grilletjesus/TESIS/ERROR1.png

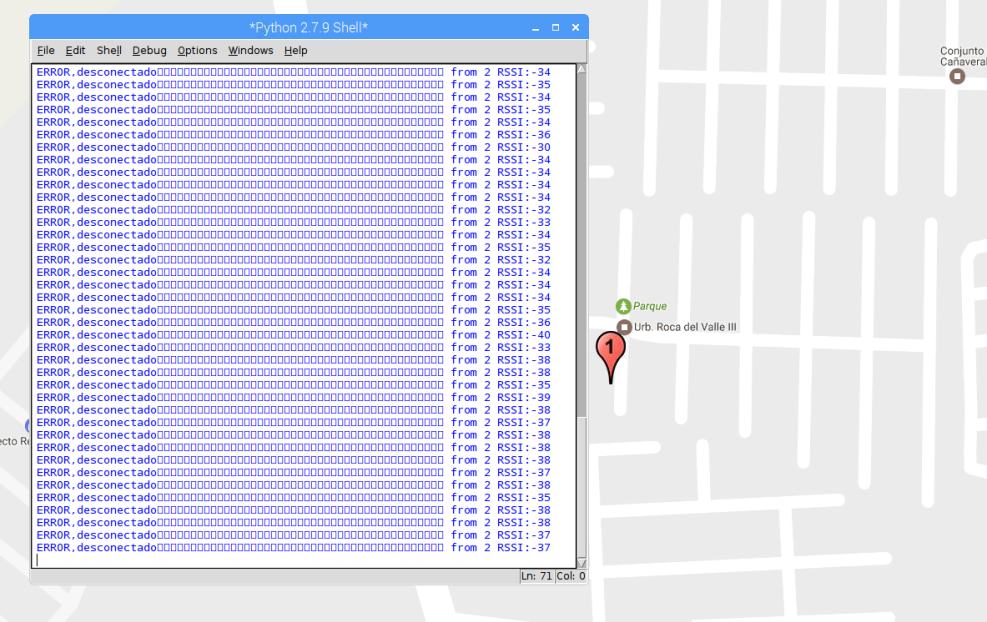
ERROR1.png
