grilletjesus/TESIS/ERRORconmapa.png

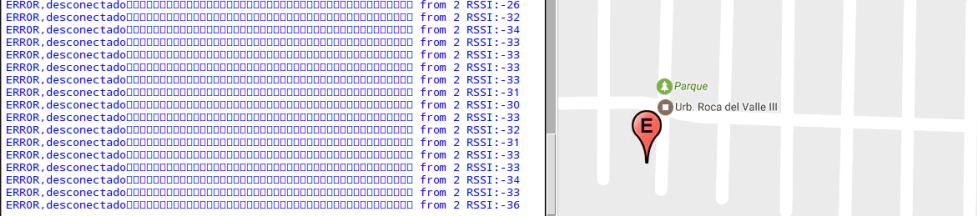
ERRORconmapa.png
