grilletjesus/TESIS/TrabajoFinalv1.docx

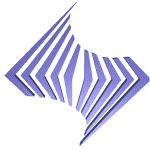
[picture p3: figure]
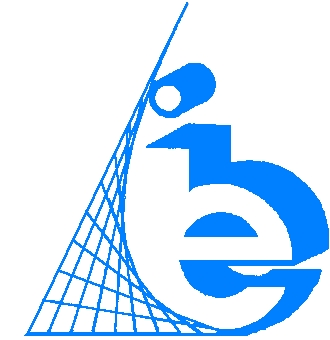
[picture p4: figure]

| U N E X P O | UNIVERSIDAD NACIONAL EXPERIMENTAL POLITÉCNICA “ANTONIO JOSÉ DE SUCRE” VICERRECTORADO BARQUISIMETO DEPARTAMENTO DE INGENIERÍA ELECTRÓNICA

SISTEMA INALÁMBRICO DE RASTREO Y MONITORIZACIÓN PARA REBAÑOS DE GANADO.

Autor: Br. Jesús Manuel Grillet González

Expediente: 20092-0338

Tutor: Dr. Jorge Agüero

Marzo, 2016

RESUMEN

INTRODUCCIÓN

CAPÍTULO I

PLANTEAMIENTO DEL PROBLEMA

DESCRIPCIÓN DEL PROBLEMA

En la actualidad el crecimiento poblacional y sus imprescindibles necesidades de alimentación han llevado al aumento del número de pequeños productores y de la producción de las empresas agropecuarias, las cuales cada cierto tiempo requieren incrementar el tamaño y/o cantidades de ganado y áreas de siembra, para satisfacer las necesidades de la población. En consecuencia, se precisa mucho más personal para mano de obra, vigilancia, regulación y gerencia de los diversos recursos y materias que se producen.

La situación coyuntural económica y social que se desarrolla en el país, presenta diversas problemáticas para las empresas de producción. Entre estos problemas se encuentran el auge en el crimen, robos, secuestros y asesinatos. Ligado con esta problemática, la falta de alimentos y los altos costos de los productos, generan un ambiente de constante peligro.

El abigeato, actualmente, es un problema común en granjas de crianza de ganado, la amplia extensión de terrenos y la falta de constante vigilancia, ha permitido la proliferación de este acontecimiento, la mayoría de las veces sin testigos ni culpables a los cuales presentar cargos. Esta situación, de sostenerse de forma prolongada a través del tiempo, degradaría aún más la situación de las empresas productoras, generando pérdidas sumadas a la situación de desestabilidad económica, pudiendo dejarlas en bancarrota.

Para controlar y dar solución a esta situación constante de abigeato de ganado, se propone el desarrollo de un sistema de rastreo y seguridad para el ganado que permita mantener una vigilancia constante.

Un sistema de rastreo consiste de varias etapas: captura de la posición mediante un GPS, procesamiento e interpretación de los datos obtenidos, visualización de la posición y, finalmente, una base de datos que registre la información. Un sistema de seguridad consiste en un detector y un dispositivo de notificación y acción al momento de ser detectada la situación no deseada que cumple parámetros previamente establecidos.

Se plantea el desarrollo de un sistema inalámbrico de rastreo y monitorización para rebaños de ganado compuesto por collares que serán los sistemas de adquisición y transmisión de datos, a su vez se subdividen en nodos principales que son transmisores de larga distancia, nodos secundarios de corta distancia y una central de control estacionaria que se ubicaría en un punto de supervisión.

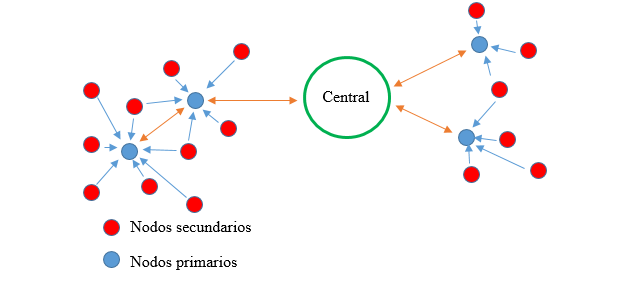
[picture p5: figure]

Figura 1.1 Diagrama del sistema

En la figura se observa un ejemplo de cómo los nodos secundarios en color rojo, enviarían su señal a los nodos principales los de color azul, quienes se encargan de transmitir la información a la central del sistema.

Los nodos primarios son collares que poseen una circuitería más compleja por lo que serán colocados a una cantidad pequeña de animales en el rebaño, mientras que al resto le será colocado el nodo secundario que es un collar más simple y de costo reducido.

La información de localización será obtenida en el nodo principal mediante un collar que estará compuesto por un microcontrolador, un sistema de posicionamiento global (GPS.), un transceptor inalámbrico, batería y un circuito de seguridad del collar, como se observa en el diagrama continuación.

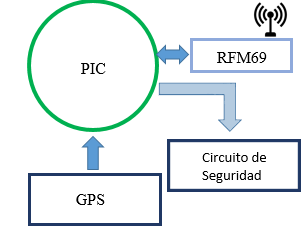
[picture p6: figure]

Figura 1.2 Nodo Principal

El circuito de seguridad consistirá en un par de cables en la parte interna de la correa del collar, por los cuales fluirá una corriente eléctrica, al ser removido el collar o ser cortada la correa se perdería esta señal generando una interrupción y activando una alarma.

El nodo secundario estará compuesto por un microcontrolador, un transceptor inalámbrico y un circuito de seguridad como se muestra en el siguiente diagrama.

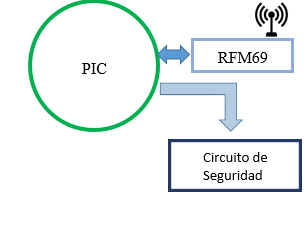
[picture p7: figure]

Figura 1.3 Nodo secundario

La información será transmitida a una central estacionaria, compuesta por una computadora Raspberry Pi, un transceptor inalámbrico, una interfaz visual y la circuitería de notificación.

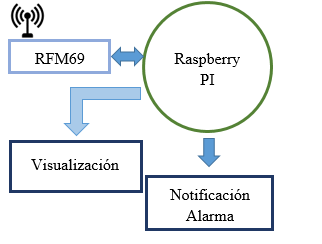
[picture p8: figure]

Figura 1.4 Central estacionaria

La Raspberry Pi es una computadora embebida la cual procesará los datos obtenidos de nodos principales en el ganado para ser registrados, mostrados y, en caso de ser necesario, realizar las notificaciones o alertas que se requieran.

JUSTIFICACIÓN

La ganadería representa para los venezolanos, y para las personas de todos los gentilicios, una fuente de producción de alimentos, de desarrollo económico y autosuficiencia del país. Esto implica un gran impacto tanto económico como social, la necesidad presentada por sectores de la población ha llevado al abigeato de cabezas de ganado, ya sea por necesidad de alimentación o por fines de lucro para los trasgresores de la ley.

La problemática de abigeato de cabezas de ganado, mencionada anteriormente, se prevé que se agudice por la degradación de la situación económica y social del país. El desarrollo de un sistema de rastreo y monitoreo inalámbrica facilitará la localización del rebaño, en llano y pradera, y alertará, de manera inmediata, si el rebaño se acerca al límite del territorio o si se detecta la remoción del collar.

La solución a esta problemática, si bien no mejoraría de manera significativa la situación económica y social del país, si sería un avance para el desarrollo tecnológico en materia de agropecuaria y seguridad, además ofrecería seguridad a la inversión que se realiza, reduciendo pérdidas y, por consiguiente, el valor final del producto, lo cual sería un gran beneficio para todos en el largo plazo.

OBJETIVOS

Objetivo General

Desarrollar un sistema inalámbrico de rastreo y monitorización para rebaños de ganado.

Objetivos Específicos

- Proponer los dispositivos, módulos e instrumentos a ser utilizados para la adquisición, procesamiento y transmisión de los datos en función de su desempeño.
- Desarrollar el software que permita, al microcontrolador, la interpretación de los formatos NMEA de geolocalización utilizado por el módulo GPS.
- Desarrollar el software en PIC y Raspberry PI que realice la comunicación entre ellos mediante el uso de un transceptor inalámbrico.
- Desarrollar el software de la estación central para monitoreo de los distintos collares, que ejecute: el registro, la visualización, la generación de alarmas en el rebaño que está siendo rastreado.
- Construir el hardware para el prototipo del collar que permita la adquisición y transmisión de los datos de geolocalización.
- Construir el hardware de recepción de datos y de notificación audiovisual para la central estacionaria.
- Evaluar el funcionamiento del prototipo por medio de pruebas que verifiquen su correcto funcionamiento.

ALCANCES Y LIMITACIONES

El sistema de rastreo y monitorización desarrollado tiene como meta principal vigilar la localización, seguridad de animales en campos abiertos, y la visualización de estas variables en un entorno grafico e intuitivo.

Se elabora solo un dispositivo de adquisición de datos y la central estacionaria de monitoreo, notificación y visualización de los datos. Para realizar las pruebas y validaciones del sistema.

El rango de transmisión de los datos está condicionado por las características geográficas en las cuales se encuentre desplegado el dispositivo.

CAPÍTULO II

MARCO TEÓRICO

ANTECEDENTES

En los últimos años ha surgido una amplia variedad de tecnología en el ámbito de monitoreo y localización de animales, tanto domésticos como salvajes, las cuales han sido empleadas en diversos países con distintas aplicaciones dando soluciones a problemas presentados.

Huircan (2009). Desarrolla junto a un equipo multidisciplinario en la universidad de la frontera Chile, un sistema es una plataforma TIC para el rastreo remoto de ganado en ambiente de pastoreo, esta plataforma apunta a monitorear variables biológicas y localización de bovinos en pradera, variables que permiten la determinación de enfermedades, celo y robo. Esta considera los siguientes elementos para realizar el monitoreo: dispositivos fijos instalados dentro del perímetro que define el predio, dispositivos móviles instalados en la oreja del animal, un dispositivo administrador por predio el cual se encarga de adquirir, registrar, calcular y transmitir alámbrica o inalámbricamente a través de un protocolo propietario variables de temperatura y localización espacial de cada animal en predio a intervalos fijos de tiempo y configurables.

De este trabajo se toman la idea principal de un sistema de localización de bovinos en pradera y su monitoreo para evitar su robo, la utilización de una computadora principal administradora que se encargue de recopilar, registrar y mostrar las variables de posición y seguridad de cada animal en intervalos fijos de tiempo configurables.

Casanova-Chirino (2014). En su trabajo describen el funcionamiento y rendimiento de la computadora Raspberry Pi B antecesor de la computadora usada como administrador central del sistema desarrollado en este trabajo. Proporciona las bases teóricas del funcionamiento tanto en software como en hardware, las limitaciones, alcances y funcionalidades que posee, esta computadora, para el desarrollo de aplicaciones tecnológicas.

Hoss (2015). En su trabajo de grado realizó un sistema de rastreo y monitoreo de unidades del sistema de transporte. Este sistema está compuesto por un sistema de adquisición de datos, una interfaz usuario-máquina y un sistema SCADA. Para la adquisición de datos uso un módulo GPS y un microcontrolador PIC, describe el funcionamiento del GPS, el formato NMEA y cómo interpretarlo; también realiza la comunicación entre el modulo y el microcontrolador usando comunicación serial. Este trabajo realiza un aporte fundamental en el desarrollo del sistema de adquisición de datos y representa un modelo de partida para el diseño del collar a ser usado como rastreador.

BASES TEÓRICAS

Para comprender el funcionamiento del sistema inalámbrico de rastreo y monitorización, es necesario explicar los soportes teóricos que se relacionan a este trabajo.

Sistemas de rastreo

Un sistema es un conjunto de elementos relacionados entre sí que contribuyen para la realización de un determinado objetivo o función. Cuando se habla de sistema inalámbrico se dice que se realiza una comunicación eléctrica que no utiliza alambres conductores, se establece sin cables que interconecten físicamente los equipos.

El rastreo es la acción de buscar algo o alguien siguiendo una señal o huella que se ha dejado al pasar por un lugar. Un sistema inalámbrico de rastreo es un conjunto de elementos dispuestos con el objetivo de buscar las señales dejadas, de forma inalámbrica, para la localización o seguimiento de algo o alguien.

Para obtener la localización o el posicionamiento de lo que está siendo rastreado existen dos clasificaciones principales de sistemas de posicionamiento:

- Posicionamiento por Satélite: Sistema que utiliza, como su nombre lo indica, señales enviadas por satélites para determinar la posición en cualquier lugar sobre la tierra, el sistema pionero es el conocido como sistema de posicionamiento global (GPS).
- Posicionamiento basado en redes de comunicaciones: Este sistema se subdivide en tres tipos posicionamiento en redes móviles, redes inalámbricas locales y por sensores en redes ad-hoc.

El sistema de rastreo a ser desarrollado deberá poder ser utilizado en zonas rurales, que normalmente poseen muy pocos o ningún tipo de conexiones a redes de comunicaciones alámbricas o inalámbricas. Tomando en cuenta esta consideración se inclina por la utilización del sistema de posicionamiento por satélite específicamente el Sistema de Posicionamiento Global (GPS).

Sistema de Posicionamiento Global (GPS)

Es un sistema diseñado por el Departamento de Defensa de los Estados Unidos, el cual permite determinar la posición de un objeto, persona o vehículo en cualquier parte del mundo con una precisión de hasta centímetros. El GPS se constituye conjuntamente de una red de computadoras y una constelación de 24 satélites en órbita sobre la tierra, para determinar por triangulación la latitud, longitud y altitud de cualquier objeto sobre la superficie terrestre.

El sistema GPS tiene por objetivo calcular la posición de un punto cualquiera en un espacio de coordenadas (x, y, z), partiendo del cálculo de las distancias del punto a un mínimo de tres satélites cuya localización es conocida. La distancia entre el usuario (receptor GPS) y un satélite se mide multiplicando el tiempo de vuelo de la señal emitida desde el satélite por su velocidad de propagación Para medir el tiempo de vuelo de la señal de radio es necesario que los relojes de los satélites y de los receptores estén sincronizados, pues deben generar simultáneamente el mismo código.

El Sistema Global de Navegación por Satélite que provee datos de navegación (Posición, Velocidad, Tiempo) a usuarios militares y civiles alrededor del mundo, fue creado en dos modos de funcionamiento para proveer servicios tanto a civiles como militares, estos son; el SPS (Standard Positionning System) para civiles y el PPS (Precise Positionning System) reservado inicialmente al ejército de Estados Unidos, y con una precisión mayor al SPS. Actualmente puede ser usado por civiles.

Protocolo de comunicaciones

Los protocolos de comunicación son las reglas y normas predeterminadas para realizar un proceso de comunicación. Los protocolos instituyen los parámetros que determinan cuál es la semántica y cuál es la sintaxis que deben emplearse en el proceso comunicativo en cuestión. Las reglas fijadas por el protocolo también permiten recuperar los eventuales datos que se pierdan en el intercambio.

Existen diversos protocolos de comunicación, para realizar las conexiones entre los dispositivos que serán usados en este proyecto, se utilizaran:

NMEA

NMEA es un protocolo definido y controlado por la National Marine Electronics Association, donde define una interfaz eléctrica y protocolo de datos para las comunicaciones entre instrumentos marinos y la mayoría de receptores GPS.

Este protocolo se basa en cadenas de caracteres codificadas en ASCII, comienzan siempre con el carácter “$” y luego el nombre de la sentencia NMEA seguida de un determinado número de campos de datos.

Las sentencias NMEA empiezan con las letras GP y la trama completa es de la forma: $SENTENCIA,campo1,campo2,…,campoN. El tamaño de cada trama depende del tipo de sentencia. Las principales sentencias del Estándar NMEA-0183 son:

- GPGGA: Datos fijos del sistema de posicionamiento global.
- GPGLL: Posición Geográfica Latitud/Longitud.
- GPGSA: Datos de los satélites en general.
- GPGSV: Datos de un satélite detallado.
- GPRMC: Datos mínimos de posicionamiento, tiempo y velocidad.
- GPVTG: Datos de rastreo y velocidad de movimiento.

En el siguiente ejemplo podemos observar una trama NMEA cuando el receptor obtiene de forma correcta las coordenadas para la sentencia $GPGLL.

$GPGLL,1001.81772,N,06916.74452,W,022512.00,A,A*7E

UART

UART (Universal Asynchronous Receiver-Transmitter) es un protocolo de comunicación por el cual se envían paquetes de datos en series de bits de forma secuencial y el receptor se encarga de ensamblar estos bits.

El protocolo UART en microcontroladores se puede describir como un par de líneas de datos simples, una para transmitir y otra para recibir. Los datos comúnmente son transmitidos de la siguiente forma: un bit de inicio, un cero lógico, 8 bits de datos y un bit de detención, un uno lógico. Se debe fijar el parámetro velocidad de transmisión, la tasa de bits, en los dispositivos para lograr la comunicación. Se pueden utilizar tensiones de 3.3V o 5V dependiendo del microcontrolador que vaya a ser utilizado.

SPI

SPI es un bus de tres líneas, sobre el cual se transmiten paquetes de información de ocho bits. Cada una de estas líneas porta la información entre los dispositivos conectados y cada uno de estos dispositivos puede actuar como transmisor y receptor al mismo tiempo, por lo que este tipo de comunicación es full dúplex. Dos de estas líneas del bus son de datos, una de transmisión y una de recepción, y la tercera línea es la de reloj.

Los dispositivos conectados al bus son definidos como maestros o esclavos. El maestro es aquel que inicia la transferencia de información sobre el bus y genera las señales de reloj y control. El esclavo es el dispositivo controlado por el maestro a través de una línea selectora y se activa solo cuando el maestro lo selecciona

La señal sobre la línea de reloj (SCLK) es generada por el maestro y sincroniza la transferencia de datos. La línea MOSI (Master Out Slave In) transporta los datos del maestro hacia el esclavo. La línea MISO (Master In Slave Out) transporta los datos del esclavo hacia el maestro.

RECURSOS DE HARDWARE

GPS U-blox NEO-6M-0-001

El NEO-6M es un receptor GPS autónomo que presenta el motor de posicionamiento de alto rendimiento u-blox 6. Este flexible y económico receptor ofrece numerosas opciones de conectividad en un paquete miniatura de 16 x 12.2 x 2.4 mm. Su arquitectura compacta, su opciones de energía y memoria hacen al módulo NEO-6 ideales para dispositivos móviles con baterías que tienen restricciones de espacio y costo.

El motor u-blox 6 de 50 canales cuenta con un tiempo de primera fijación (Time-To-First-Fix TTFF) de menos de 1 segundo que le permite encontrar los satélites instantáneamente.

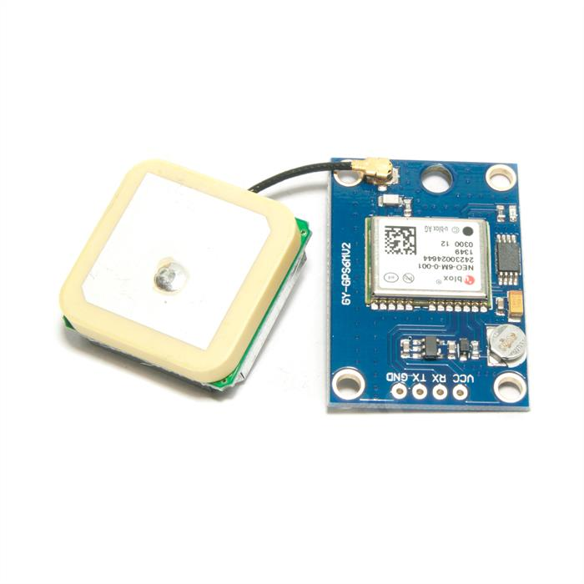
[picture p9: figure]

Figura 2.2 U-blox NEO-6M. Fuente:

https://makertree.azurewebsites.net/196/18/ublox-neo-6m-gps-module-and-25mm-antenna-7164.jpg

PIC18F4550

Es un microcontrolador de ocho bits elaborado por Microchip, pertenece a la familia de los PIC18, entre las características más resaltantes que posee se encuentran: 32Kb de memoria de datos, 2048Kb de memoria RAM, 256 bytes de memoria EEPROM, 40 pines de entradas y salidas de los cuales 13 son canales analógicos de 10 bits, su voltaje de entrada puede ser de 2 a 5V. Protocolos de comunicación que soporta: UART, A/E/USART, SPI, I2C, posee un puerto para comunicación USB, su velocidad máxima es de 48 MHz y su forma de programación es tipo flash usando Assembler o lenguaje C.

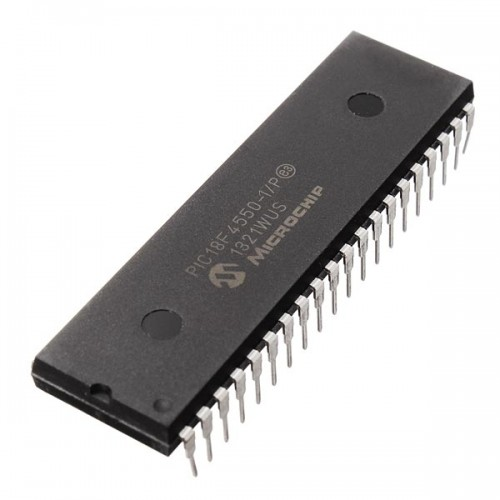
[picture p10: figure]
Resultado de imagen para PIC18F4550

Figura 2.3 PIC18F4550 Fuente: http://www.refactron.com/image/cache/catalog/Partes%20y%20Componentes/Micros/PIC18F4550-500x500.jpg

RFM69HCW

El RFM69HCW es un módulo transceptor capaz de operar sobre un amplio rango de frecuencias, incluyendo la 315.433.868 y la banda libre ISM de 915MHz. Todos los parámetros principales de comunicación RF son programables y la mayoría de ellos se pueden ajustar dinámicamente. El RFM69HCW esta optimizado para el bajo consumo de energía mientras ofreces un alto poder de salida RF y operación canalizada. Características principales: +20dBm - 100mW capacidad de poder de salida, alta sensibilidad de -120dBm a una tasa de 1.2 kbps, modulaciones; FSK, GFSK, MSK, GMSK y OOK. Con un tamaño de 16 x 16mm.

Raspberry PI 2 modelo B

La Raspberry Pi es una computadora de tamaño de tarjeta de crédito originalmente diseñada para la educación, inspirada en la BBC Micro de 1981. El objetivo del creador Eben Upton era crear un dispositivo de bajo costo que mejoraría las habilidades de programación y la comprensión del hardware en el nivel preuniversitario. Pero gracias a su pequeño tamaño ya su precio accesible, fue rápidamente adoptado por fabricantes, fabricantes y entusiastas de la electrónica para proyectos que requieren más de un microcontrolador básico (como dispositivos Arduino).

El Raspberry Pi es más lenta que una computadora portátil o escritorio, pero sigue siendo una computadora Linux completa y puede proporcionar todas las habilidades esperadas que implica, a un nivel de bajo consumo de energía.

La Raspberry Pi 2 modelo B es la segunda generación de Raspberry Pi. Sus principales características son:

- Una CPU ARM Cortex-A7 de cuatro núcleos de 900MHz
- 1 GB de RAM
- 4 puertos USB
- 40 pines GPIO
- Puerto HDMI completo
- Puerto Ethernet
- Conector de audio combinado de 3,5 mm y vídeo compuesto
- Interfaz de la cámara (CSI)
- Interfaz de pantalla (DSI)
- Ranura para tarjeta micro SD
- VideoCore IV núcleo de gráficos 3D

Debido a que tiene un procesador ARMv7, puede ejecutar toda la gama de distribuciones ARM GNU / Linux, incluyendo Raspbian, Snappy Ubuntu Core, así como Microsoft Windows 10 IoT core. Raspbian es el sistema operativo oficial de la fundación Raspberry pi está basado en Debian y viene preinstalado con una variedad de software para programación y uso general.

RECURSOS DE SOFTWARE

PCWHD Compiler CCS

Es un compilador ANSI C altamente optimizado y rico en funciones para Microchip PIC ® MCUs. Nuestro C-Aware IDE proporciona a los desarrolladores con un conjunto de herramientas y un código inteligente que optimiza el compilador Microchip PIC ® C que libera a los desarrolladores para concentrarse en la funcionalidad de diseño en lugar de tener que convertirse en un experto en arquitectura MCU. C-Aware permite a los desarrolladores gestionar todos los aspectos de su desarrollo de software integrado, desde el diseño hasta la programación y depuración de dispositivos. Es el entorno ideal para desarrollar código de programa C con funciones incorporadas integradas, análisis de rendimiento y estadísticas, y depuración de código compilado en tiempo real mientras se ejecuta en dispositivos Microchip PIC ® MCU.

PCWHD IDE Compiler Ventajas:

- Funciones integradas: incluye bibliotecas para SPI, ADC, I2C, temporizadores, PWM y más ...
- Controladores periféricos externos: acelera el desarrollo de dispositivos y aplicaciones
- Programas de ejemplo - Iniciar rápidamente un proyecto con un gran número de programas pregrabados
- Optimización Pro-Level - El código optimizado reduce los costos de producción
- Project Wizard: Inicia y configura muchos periféricos de aplicaciones
- Elementos de vigilancia del depurador: permiten un fácil seguimiento de las variables de estructura y matriz
- Versiones múltiples del compilador - capacidad de utilizar versiones específicas para los proyectos específicos

Python

Python es un lenguaje de programación fácil de aprender y potente. Tiene estructuras de datos eficientes de alto nivel y un enfoque simple pero efectivo para la programación orientada a objetos. La elegante sintaxis y la tipificación dinámica de Python, junto con su naturaleza interpretada, lo convierten en un lenguaje ideal para el desarrollo de scripts y aplicaciones rápidas en muchas áreas de la mayoría de las plataformas.

El intérprete de Python y la amplia biblioteca estándar están disponibles gratuitamente en forma de código fuente o binario para todas las plataformas principales desde el sitio Web de Python, https://www.python.org/, y pueden distribuirse libremente. El mismo sitio también contiene distribuciones y punteros de muchos módulos de Python de terceros gratuitos, programas y herramientas y documentación adicional.

El intérprete de Python se amplía fácilmente con nuevas funciones y tipos de datos implementados en C o C ++ (o en otros idiomas llamados desde C). Python también es adecuado como un lenguaje de extensión para aplicaciones personalizables.

Proteus PCB Design & Simulation software

Proteus professional es una combinación de software del programa de captura esquemática ISIS y del programa de diseño ARES PCB. Se trata de un entorno de desarrollo potente e integrado. Las herramientas en este programa son muy fáciles de usar y estas herramientas son muy útiles en la educación y el diseño profesional de PCB. Como un software profesional de diseño de PCB con un enrutador automático de espacio integrado, proporciona características tales como captura esquemática, reglas altamente configurables del diseño, simulador interactivo de circuitos SPICE, soporte extenso para los planos de la energía, salida estándar de CADCAM & ODB ++ de la industria y espectador 3D integrado.

CAPÍTULO III

MARCO METODOLÓGICO

3.1 Naturaleza de la Investigación

El presente trabajo especial pertenece a la modalidad de Proyecto Especial, ya que está orientado al desarrollo de un sistema que permitirá solventar una problemática surgida en granjas, hatos y haciendas de producción agropecuaria.

Según el Manual de Trabajos de Grado de Especialización y Maestría y Tesis Doctorales de la UPEL (2006), un Proyecto Especial está definido como:

Trabajos que lleven a creaciones tangibles, susceptibles de ser utilizadas como soluciones a problemas demostrados, o que respondan a necesidades e intereses de tipo cultural. Se incluyen en esta categoría los trabajos de elaboración de libros de texto y de materiales de apoyo educativo, el desarrollo de software, prototipos y de productos tecnológicos en general, así como también los de creación literaria y artística.

El propósito de este trabajo busca la resolución del problema mediante la creación de un sistema tangible que con lleva la elaboración de un prototipo, el desarrollo de software necesario para el control y la visualización de variables e información. Así como también el avance en el desarrollo de nuevas tecnologías para la aplicación.

3.2 Etapas de la Investigación

El sistema que se desea construir posee las características de dos bloques funcionales: adquisición de la información de locación y seguridad, y la recepción de la información, visualización y notificación en la central estacionaria.

3.2.1 Etapa I: Adquisición de datos de localización y seguridad.

La metodología a seguir en esta etapa se muestra a continuación en la figura 3.1

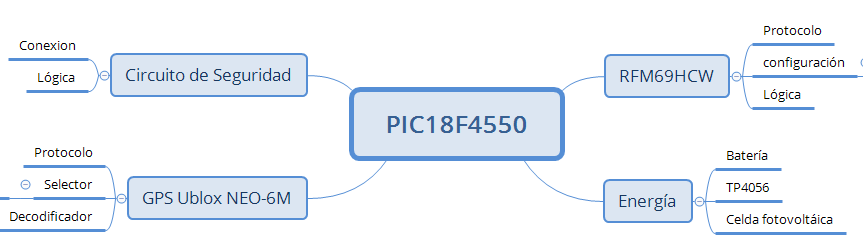
[picture p11: figure]

Es importante definir las características generales que deben cumplirse en cada bloque para completar exitosamente la construcción del dispositivo de adquisición de datos.

- Comunicación GPS – Microcontrolador.

Los datos generados por el modulo GPS deberán ser recibidos y almacenados en el microcontrolador. Para la captación de esta información deberá ser desarrollado el software para el microcontrolador que sea capaz de almacenar de manera adecuada los datos de localización y que también sea capaz de diferenciar si la información recibida es coherente.

- Transmisión de los datos comunicación Microcontrolador – RFM69.

Se requiere la transmisión de los datos para su procesamiento y posterior visualización y/o notificación de eventos. Para esto se le agrega un dispositivo de transmisión en radio frecuencia, el cual debe ser capaz de transmitir a distancias considerables a un bajo consumo de energía eléctrica.

- Seguridad.

Se debe adicionar al sistema el circuito detector de la remoción del dispositivo de adquisición de datos y añadir la programación, al software del microcontrolador, necesaria para la respuesta a este evento.

- Energía.

Un dispositivo inalámbrico debe tener una fuente de alimentación portátil compuesta de una batería y un sistema de recarga de esa batería para garantizar el funcionamiento prolongado del dispositivo.

3.2.2 Etapa II: Recepción de la información, visualización y notificación en la central.

Esta etapa conlleva principalmente el desarrollo de software para la recepción de los datos, el procesamiento de los mismo, la interfaz gráfica para el monitoreo y la notificación de eventualidades y activación de alarmas. Se subdivide en las siguientes fases:

- Recepción de los datos:

Se le adiciona el transmisor de radio frecuencia a la computadora en la base estacionaria, y se desarrolla el software necesario para la utilización del mismo.

- Procesamiento de los datos

Al recibir los datos primeramente deben ser almacenados, para luego ser interpretados y de esta forma tener la información a disposición.

- Visualización

El desarrollo de una interfaz gráfica que muestre la información obtenida para que pueda ser monitoreada. Esta debe ser intuitiva y que provea toda la información necesaria para el rastreo de los animales.

- Notificación

En el caso de que se produzca una eventualidad como la remoción indebida del collar dispositivo de adquisición de datos, la salida de rango de transmisión del animal o la proximidad del animal al límite del territorio. Se debe tener un sistema de notificaciones visual y sonoro para captar la atención del supervisor que este monitoreando los animales.

Una vez desarrollado el prototipo bajo los criterios antes mencionados se realizaran pruebas preliminares para evaluar el funcionamiento del mismo, los resultados preliminares serán de utilidad para refinar los requisitos de software y hardware del sistema que esta en desarrollo.

CAPÍTULO IV

RESULTADOS Y DISCUSIÓN

El siguiente capítulo contiene la explicación del desarrollo y funcionamiento del sistema, como también los resultados obtenidos durante la elaboración del proyecto para alcanzar los objetivos planteados, consta de tres diseños: Sistema de adquisición de datos (collar), sistema central de recepción y procesamiento de los datos, y la interfaz usuario-máquina.

4.1 PROPUESTA DE LOS EQUIPOS E INSTRUMENTOS A UTILIZAR

Para el desarrollo del proyecto se propone el uso de los siguientes recursos:

4.1.1 Dispositivos de adquisición de datos collares nodos principal y secundario

Recursos de Software:

- PCWHD IDE ver 5.059 CCS inc.
- Proteus Professional.
- Altium Designer ver 15.0.7

Recursos de Hardware:

- Capacitor electrolítico 100uF
- TIP31C
- RMF69HCW
- GPS Ublox NEO-6M GY-GPS6MV2
- Cristal 20MHZ
- Resistencias (220ohm, )
- TP4056
- Batería li-ion US18650GR 2550mAh
- Celda Fotovoltaica 3.3V 100mA
- Collar de Cuero
- Cables

4.1.2 Central estacionaria

Recursos de Software:

- Python IDLE 2.7
- SQLite
- VNC server

Recursos de Hardware:

- Raspberry PI 2 modelo B
- RFM69HCW
- Edimax Wifi dongle
- Alarma

4.2 DISEÑO DEL DISPOSITIVO DE ADQUISICIÓN DE DATOS COLLAR NODO PRINCIPAL.

Se compone de tres fases para la creación del dispositivo: la interfaz Microntrolador-GPS, la interfaz Microcontrolador-Transceptor, interfaz de Seguridad y Energía.

4.2.1 Interfaz PIC18F4550 - GPS.

El dispositivo GPS Ublox NEO-6M transmite la información utilizando el formato NMEA por medio de comunicación serial RS232 de 8 bits a 9600 baudios y sin bit de paridad. Para conectar este módulo con el PIC18F4550 se utilizó el puerto UART integrado en el dispositivo.

Utilizando el software PCWHD IDE compilador CCS con programación en lenguaje C, se programó el microcontrolador para que cada 2 minutos active el modulo GPS, mediante el uso de un switch compuesto por un TIP31C y resistencias, obtenga los datos que este módulo le envía y luego de recibir la información, compruebe si es válida y activar el proceso de transmisión de datos a la central.

Se realizaron pruebas del código y funcionamiento utilizando el software Proteus, utilizando dos microcontroladores en la simulación, el segundo microcontrolador para suplantar el modulo y realizar la trasmisión de los datos por puerto serial RS232.

La sentencia NMEA que el microcontrolador detecta es:

$GPRMC,022512.00,A,1001.81772,N,06916.74452,W,0.273,,101016,,,A*66

De la cual se obtiene:

Hora: 02:25.12 GMT

Latitud: 1001.81772 N

Longitud: 06916.74452 W

Valido: A (Valido).

4.2.2 Interfaz PIC18F4550-RFM69

El dispositivo transceptor RFM69HCW hace uso del protocolo SPI para la comunicación con el microcontrolador. Para la programación y control del dispositivo se hace uso de registros de 4 bytes reservados en la memoria del dispositivo, a continuación podemos observar un ejemplo:

REG_BITRATEMSB 0x03

RF_BITRATEMSB_1200 0x68

Tenemos dos valores en hexadecimal, de 2 bytes cada uno, el primero representa el registro del bit más significativo para la selección de velocidad de transmisión, mientras que los segundos dos son el valor que representa 1.2 Kbps.

Se programó en el microcontrolador una serie de rutinas para lograr el control del dispositivo, las podemos separar en tres categorías:

Rutinas de SPI: programadas para realizar la emulación a través de software de la comunicación SPI, selección del dispositivo, lectura escritura de registros. Además, para la codificación y decodificación de la información en bytes.

Rutinas de control: funciones del RFM69HCW para el envío y recepción de información, también para el chequeo de registros y selección de modo del dispositivo.

Rutinas de configuración: son aquellas que modificación los parámetros de funcionamiento del RFM69HCW entre ellas está la configuración principal del dispositivo, la selección del modo del alto consumo para mayor poder de transmisión.

En el cuerpo principal del programa se configuro los parámetros del microcontrolador el intervalo de transmisión del dispositivo y el empaquetado de los datos a ser transmitidos.

El microcontrolador fue capaz de transmitir, a través del RFM69HCW, información de prueba aun dispositivo de prueba de recepción, compuesto por un Arduino y un RFM69HCW.

4.2.3 Interfaz de Seguridad

Se necesita que el collar no sea retirado del animal al ser colocado y activado, para mantener control de la posición y estado. Para lograr esto, se introdujo un cable en la parte interna de la correa del collar que se conectó al microcontrolador el cual detectara el corte de la continuidad eléctrica del cable, permitiendo así saber si se ha retirado el collar.

4.2.4 Energía

La alimentación del dispositivo se realizó mediante un par de baterías 18650 li-ion, que proporcionan 4,2 voltios y con una capacidad conjunta de 5200mAh. Para la recarga de estas baterías se utilizó el módulo de recarga de baterías li-ion TP4056 en conjunto con una celda fotovoltaica que le proporciona la energía para recargar las baterías.

Una vez comprobado la correcta transmisión de la información, se procedió a la unión de las interfaces para tener el módulo de adquisición de datos, el collar nodo principal. Las conexiones físicas al microcontrolador fueron de la siguiente forma:

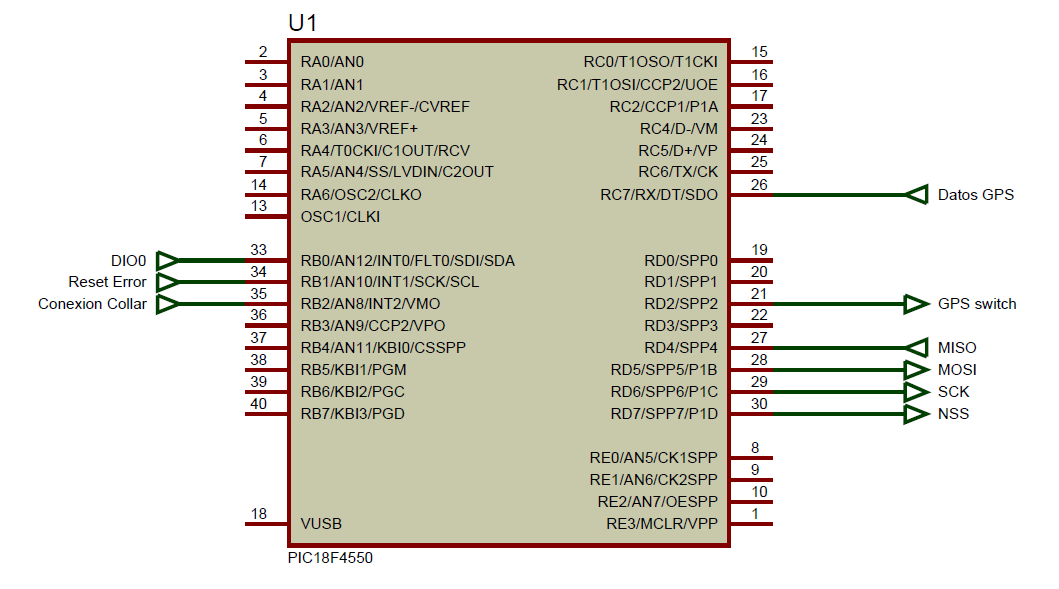
[picture p12: figure]

El comportamiento del programa principal del dispositivo lo podemos observar a continuación:

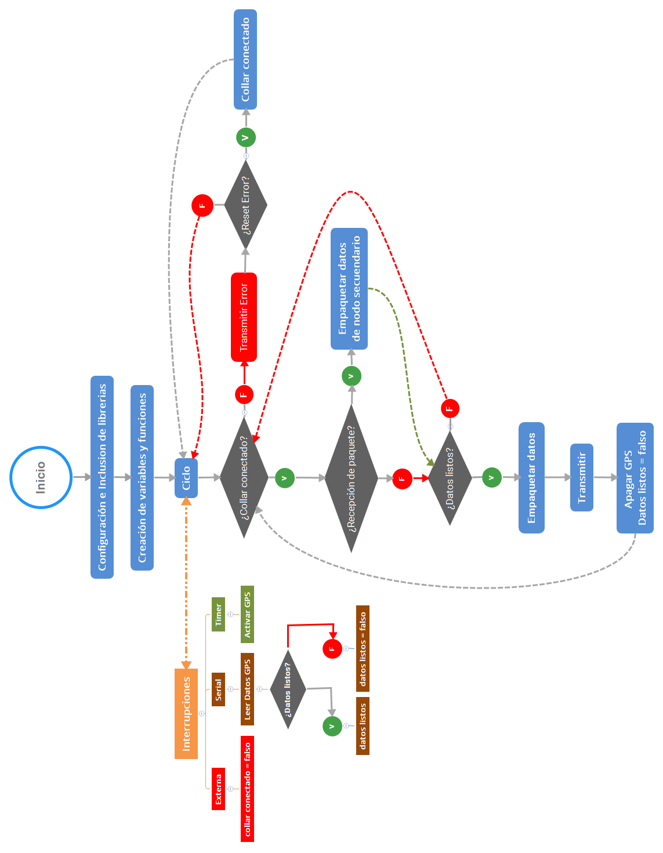
[picture p13: figure]

4.2 DISEÑO DE LA CENTRAL.

La central consiste de una computadora Raspberry PI con sistema operativo Raspbian versión Jessie, en la cual se desarrolla todo el procesamiento de la información y se muestran los resultados, y en caso de ser necesario se activan las notificaciones pertinentes. Esta etapa se subdivide en cuatro fases:

4.2.1 Recepción de datos

El dispositivo principal de la central es una Raspberry Pi 2 modelo B, la cual posee un GPIO (General Purpose Input/Output, Entrada/Salida de Propósito General) de 40 pines. Haciendo uso de este, se conectó un transceptor RFM69HCW de la siguiente manera:

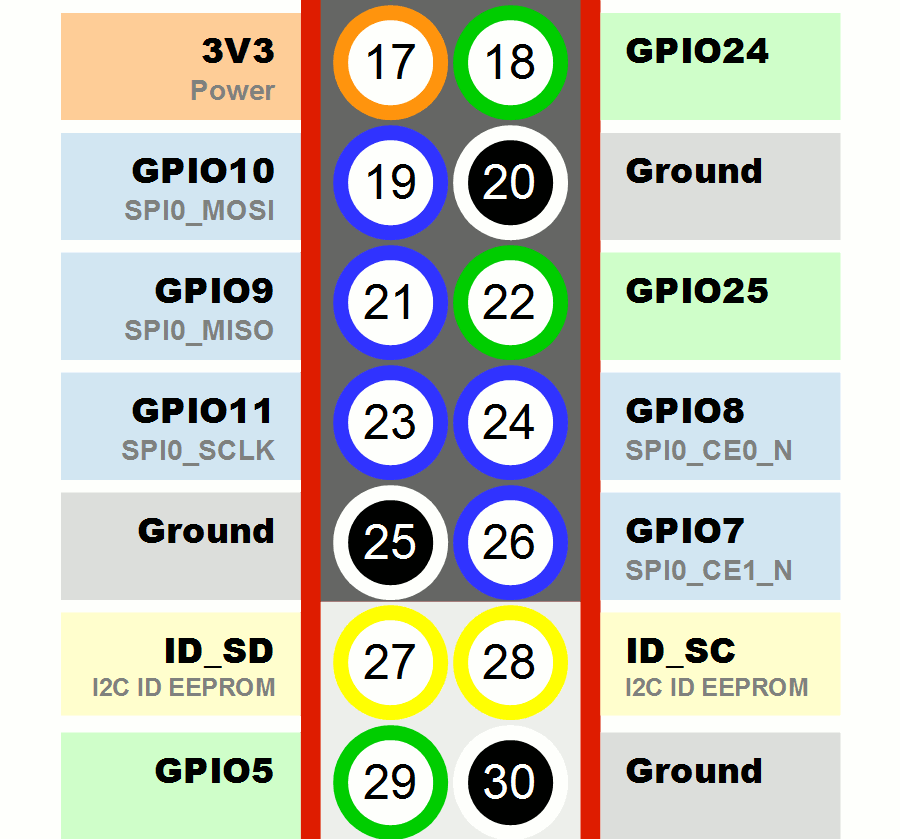
[picture p14: figure]

RFM69 DIO0

RFM69 GND

RFM69 RESET

RFM69 NSS

RFM69 SCLK

RFM69 MISO

RFM69 MOSI

RFM69 3.3V

Para poder hacer uso de estos pines mediante programación en lenguaje Python se instaló la librería py-spidev, del repositorio https://github.com/LowPowerLab/RFM69. Luego de instalar esta librería, se descargó el driver del RFM69HCW, del repositorio https://github.com/etrombly/RFM69, del cual se toman las clases y métodos a ser utilizados en el programa principal para controlar, recibir y transmitir información usando este dispositivo.

Se espera recibir paquetes de datos compuestos por 66 bytes de información, de los cuales 61 bytes serían los datos de posición, hora, fecha y nodo del cual se recibió la información. También se obtiene la potencia de la señal de recepción, al leer el registro interno del RFM69 que almacena la potencia de la señal recibida (RSSI Received Signal Strength Indication).

4.2.2 Procesamiento de los datos

Almacenar la información recibida es importante para análisis de comportamiento, de eventos que puedan haber ocurrido a los animales. Por esta razón, se desarrolló un script para realizar el almacenamiento de los datos recibidos en una base de datos usando SQLite y Python. El cual almacenara la información en una tabla que se muestra a continuación:

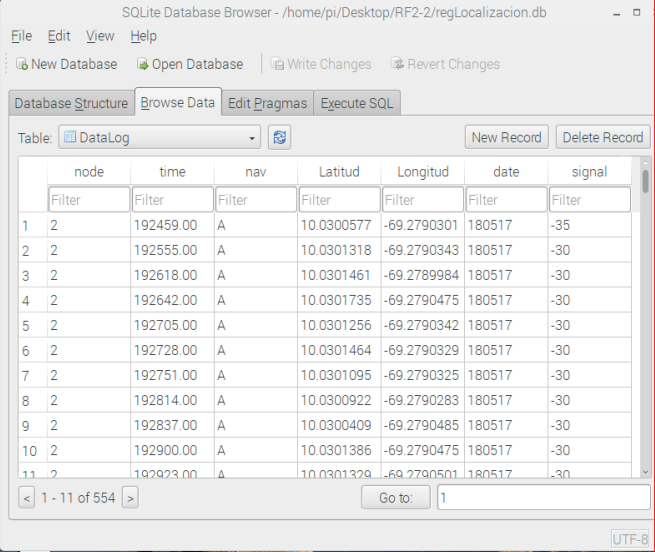
[picture p15: figure]

Para almacenar la información en cada campo de la tabla, se desempaqueta la información y luego se separa, en secciones que corresponden a los campos indicados y luego se utilizan como parámetros para la función de registro de la información que las almacena en sus correspondientes secciones.

Si el paquete recibido es una alarma o notificación de error, se activa otra rutina la cual adquiere la información de que nodo tiene error y que tipo de error presenta. Luego de identificar esto, procede a buscar el último registro valido de posición conocido de este nodo, en la base de datos mediante una rutina de búsqueda y lectura, y añade la información para tener una referencia de su última posición antes de que se presentara el error.

4.2.3 Visualización

La visualización del sistema operativo de la Raspberry PI y de la información que está contenido en su tarjeta de memoria que ha sido procesada y almacenada. Se podrá lograr con 3 métodos diferentes, se puede observar conectando directamente un cable HDMI a un monitor o un televisor con dicho puerto.

Como segundo método tenemos que mediante un cable de red conectado a una pc de escritorio o portátil, utilizando un número de IP pre-configurado se puede establecer conexión con un servidor VNC que nos provee la imagen y nos permite controlar el sistema operativo.

El tercero es mediante la utilización de wifi, la Raspberry al usar una conexión inalámbrica creara un servidor VNC en la IP provista por el router, el cual podrá ser accedido desde cualquier dispositivo con cliente VNC, sistemas Android, iOS o computadores.

Luego de poder interactuar con el sistema Raspbian, se necesita poder observar los datos almacenados y los que se recibirán. Para lograr esto se programó una interfaz visual para presentar las posiciones de los nodos, esta se logró de la siguiente manera:

Google API: se utilizó la API de google maps, que consiste en un código HTML que permite la creación de un mapa interactivo y agregarle marcadores. A este código se le harán las modificaciones pertinentes para la utilización de variables dinámicas para la creación de los marcadores y del punto central del mapa a mostrar. Entre estas modificaciones también se incluyen la utilización de lenguaje Jinja que permite la creación de variables y rutinas Python dentro de un código HTML. Se crea un archivo “mapa.html” el cual contendrá la información final ser mostrada y el cual se actualizara constantemente a medida que se reciba información nueva.

Inicialización y Visualización del mapa: En el programa principal de la central se importara la clase para la creación de mapas y su actualización. Luego de recibir un paquete de datos nuevo y de procesar dichos datos, se crea un objeto que se encargara de la creación del mapa y la actualización del mismo, pasando las variables pertinentes recibidas. Al haber creado el mapa, se llama una función de una librería standard dentro de Python que abre automáticamente el navegador con una pestaña donde se cargara el mapa y será actualizado continuamente.

4.2.4 Notificación

Dado el caso que se presente un error, se necesitara notificar de manera inmediatamente para que sean tomadas las medidas adecuadas. Para lograr esto se dispone una alarma que será conectada a la Raspberry Pi, y al programa principal una rutina de activación de la alarma al ser detectado el error.

La bocina se conectara de la siguiente manera al GPIO de la Raspberry Pi:

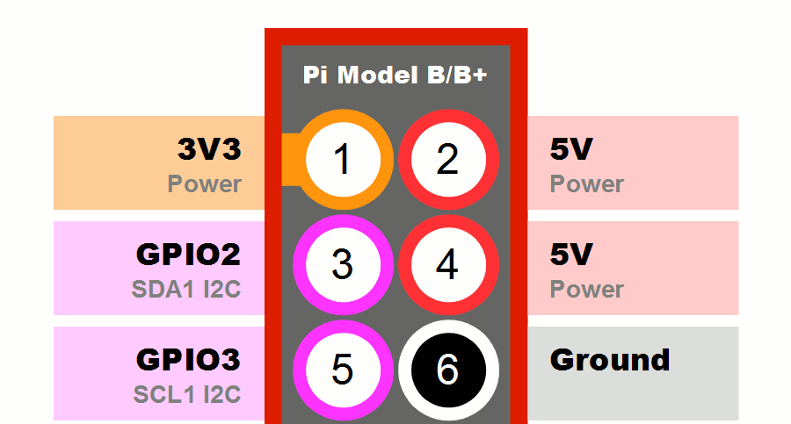
[picture p16: figure]

Bocina GND

Bocina Vcc

CAPÍTULO V

RESULTADOS Y ANÁLISIS DE RESULTADOS

En el siguiente capítulo se exponen los resultados obtenidos durante la elaboración del proyecto, para poder alcanzar los objetivos planteados se dividieron las pruebas en diferentes partes, para así poder determinar el correcto funcionamiento del mismo y mostrar el resultado final del proyecto.

5.1 Funcionamiento del dispositivo de adquisición de datos collar nodo principal.

5.1.1 Verificación del funcionamiento interfaz PIC18F4550-GPS

En esta etapa se verifica la correcta recepción de la información proveniente del módulo GPS al microcontrolador y su almacenamiento en la memoria del dispositivo.

Se verifica mediante el uso de comunicación Serial a la pc para transmitir los datos que el microcontrolador está recibiendo, a un terminal donde se puede observar gráficamente la información.

Primero se verifico la correcta recepción de la información que provee el GPS, la cual se muestra a continuación:

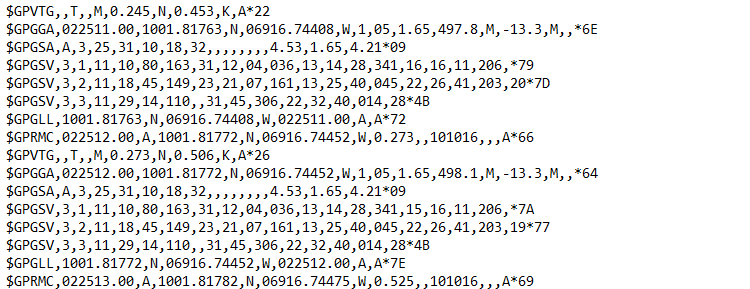
[picture p17: figure]

Luego se comprobó que el dispositivo sea capaz de reconocer los datos validos y almacene la información deseada en una variable. El resultado del envió de la información contenida dentro de esta variable se muestra a continuación:

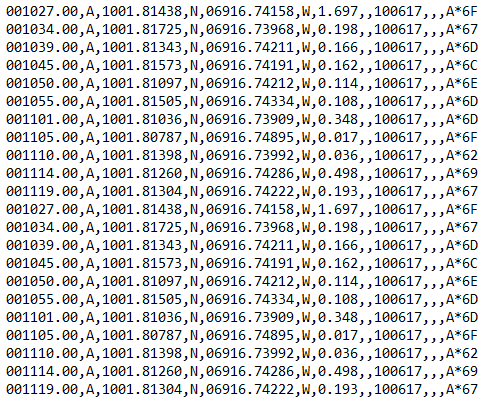
[picture p18: figure]

5.1.2 Verificación del funcionamiento interfaz PIC18F4550-RFM69HCW

Comprobar el funcionamiento de la interfaz se realizó mediante la lectura de los registros del RFM69HCW si los registros pueden ser leídos y contienen la información correcta, para observar la información que contienen los registros se leen y se envía a través de comunicación serial a la pc.

5.2 Funcionamiento de la central.

5.2.1 Pruebas de recepción de los datos.

Para comprobar la recepción de los datos primero se verifica la comunicación de la Raspberry Pi con el transceptor RFM69HCW, haciendo lectura de sus registros e imprimiendo en pantalla los resultados.

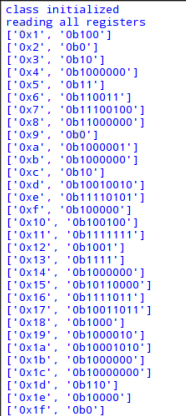
[picture p19: figure]

Luego de verificar el funcionamiento del dispositivo transceptor, se verificara la recepción de la información enviada desde el collar nodo principal, imprimiendo en pantalla cada vez que se reciba un paquete de datos.

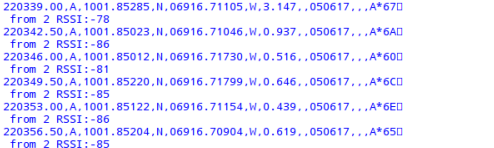
[picture p20: figure]

Como se observa en la figura se recibe la información de localización, el nodo y la señal.

5.2.2 Prueba de procesamiento de los datos

Luego de comprobar la recepción de los datos, debe ser verificado que los datos sean procesados y almacenados correctamente. Para hacerlo hacemos uso del programa SQLiteBrowser que nos permite la visualización de la base de datos, observamos que la información contenida en la base de datos coincide con la recibida.

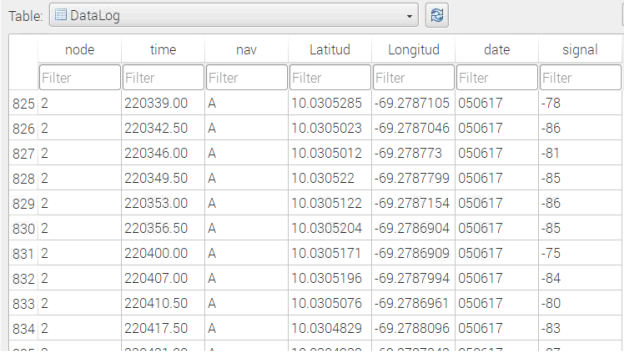
[picture p21: figure]

5.2.3 Pruebas de visualización

La información de posición recibida y almacenada se debe observar en un mapa con un marcador de posición. El mapa deberá actualizarse cada vez que se detecte una nueva información de posición recibida.

Para verificar el funcionamiento de esta etapa se observa el mapa mientras se mueve el collar de posición. A continuación se muestran dos posiciones distintas vistas en el mapa.

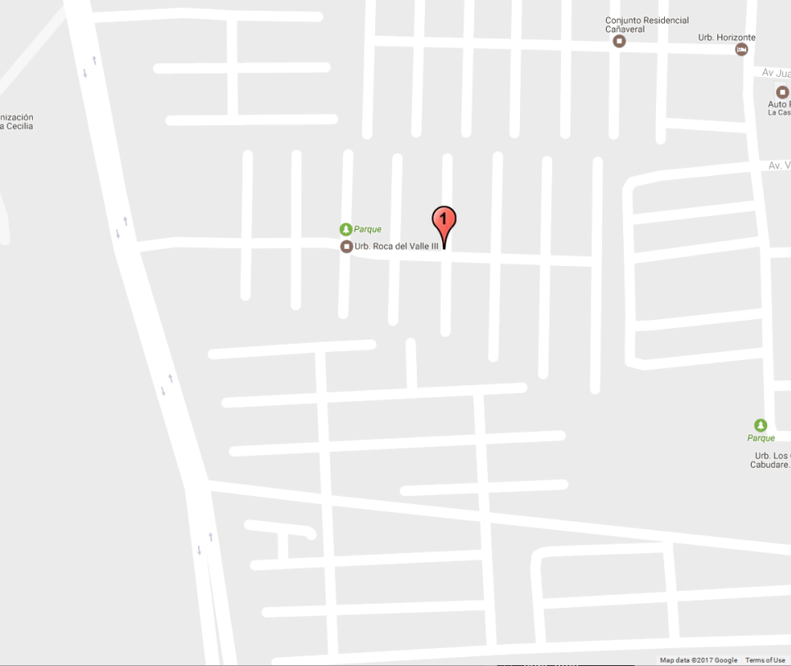
[picture p22: figure]
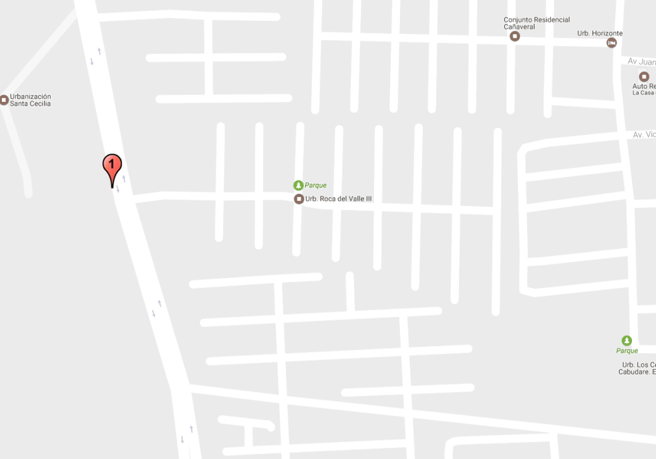
[picture p23: figure]

5.2.4 Prueba de notificación.

Primeramente se prueba la recepción y correcto procesamiento de errores, mediante la impresión del dato de error en pantalla, que observamos en la figura:

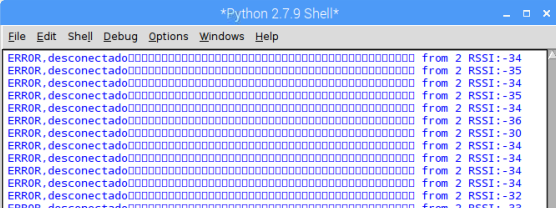
[picture p24: figure]

Luego de que se recibió correctamente el error, se procede a probar las notificaciones. Se prueba la notificación visual observando el mapa y percibiendo el cambio del marcador a indicar error en la última posición conocida del collar.


La alarma se prueba activando el error el error y conectando la bocina a los pines que la controlan, y se espera que se genere el sonido de alarma.

CONCLUSIONES

REFERENCIAS BIBLIOGRÁFICAS

Casanova y Chirino (2014). Evaluación Del Funcionamiento de la Computadora Raspberry Pi Modelo B. Trabajo Especial de Grado. Universidad Experimental Nacional Politécnica Antonio José de Sucre Vicerrectorado Barquisimeto. Barquisimeto, Venezuela.

Hoss, George (2015). Sistema de control de tránsito para el sistema de transporte masivo de Barquisimeto. Trabajo Especial de Grado. Universidad Experimental Nacional Politécnica Antonio José de Sucre Vicerrectorado Barquisimeto. Barquisimeto, Venezuela.

Huircan (2009). TICs y Ganadería: Manejo electrónico de Ganado. Workshop Internacional EIG2009 Universidad de La Frontera, Facultad de Ingeniería, Ciencias y Administración. Chile.

http://www.i-micro.com/pdf/articulos/spi.pdf

https://www.u-blox.com/sites/default/files/products/documents/NEO-6_DataSheet_%28GPS.G6-HW-09005%29.pdf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

www.microchip.com/1632

https://www.engineersgarage.com/contribution/expert/pcb-layout-design-with-proteus
