grilletjesus/TESIS/ERRORreset.png

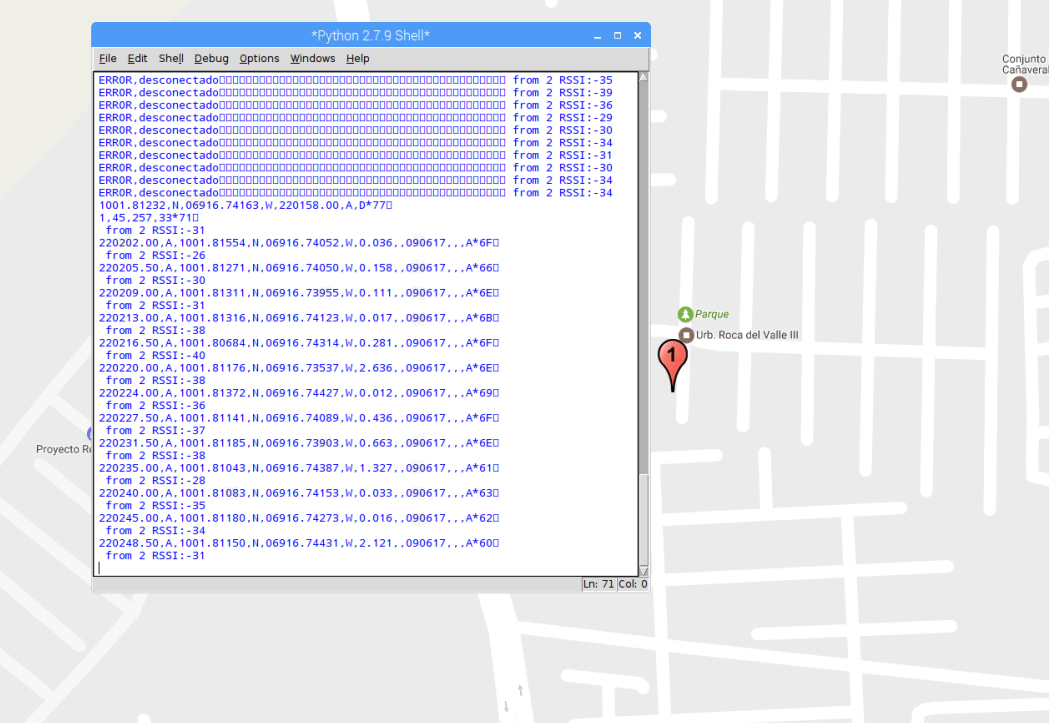
ERRORreset.png
