grilletjesus/TESIS/GPSdata.png

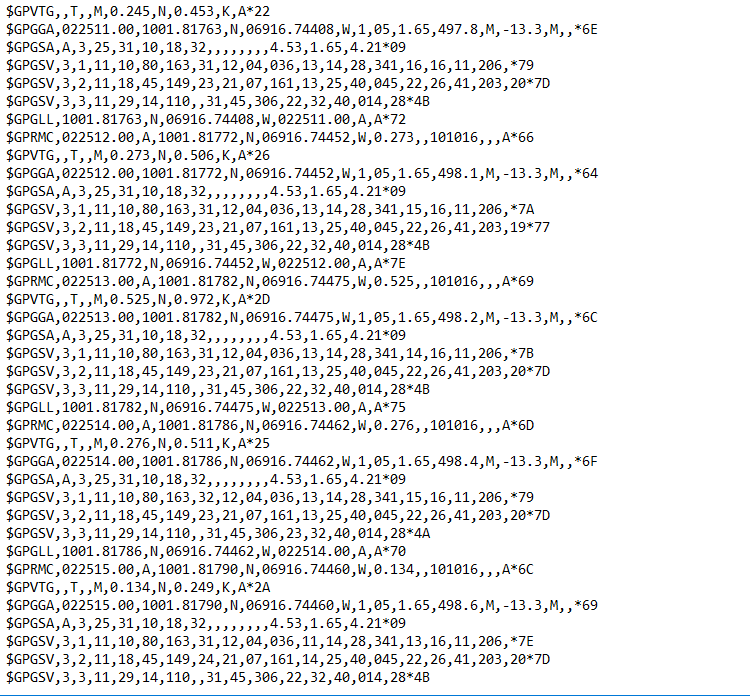
GPSdata.png
