grilletjesus/TESIS/NodoPrincipal.png

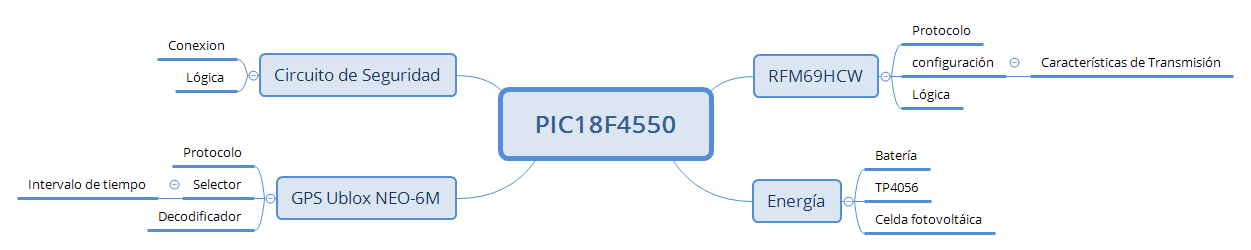
NodoPrincipal.png
