grilletjesus/TESIS/picconexiones.bmp

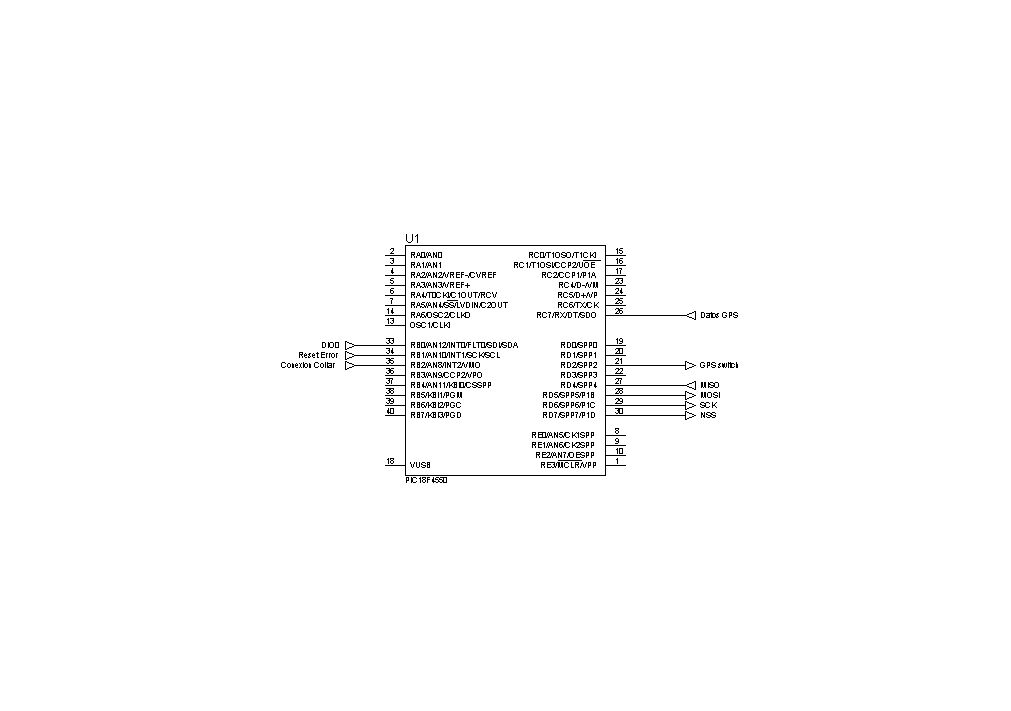
picconexiones.bmp
