grilletjesus/TESIS/Pos1.png

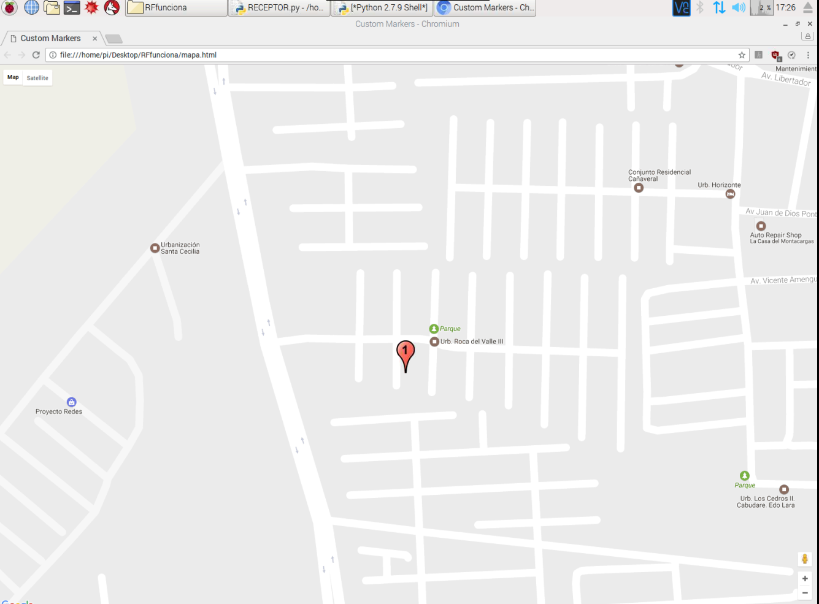
Pos1.png
