grilletjesus/TESIS/Pos2.png

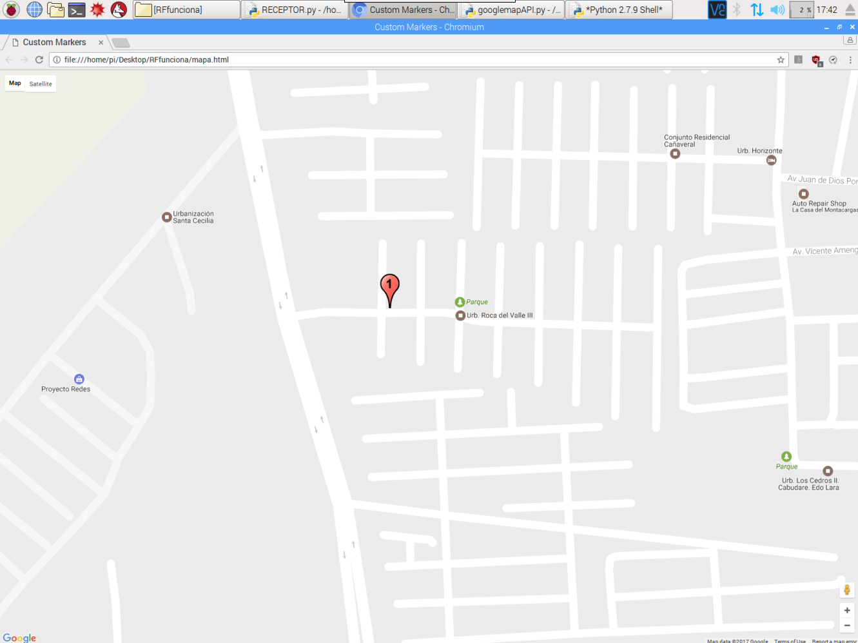
Pos2.png
