grilletjesus/TESIS/Pos6.png

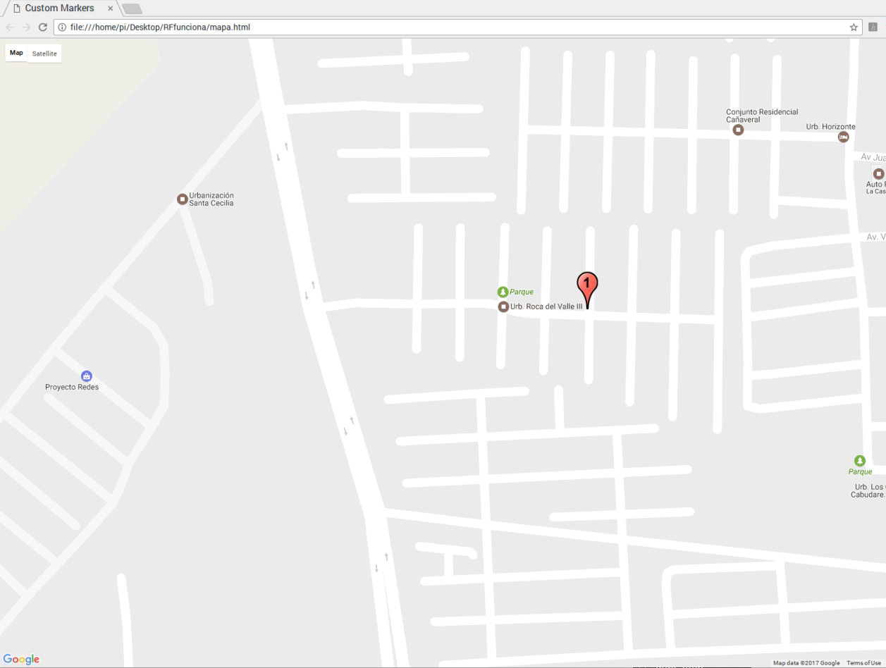
Pos6.png
