grilletjesus/TESIS/POSfinal.png

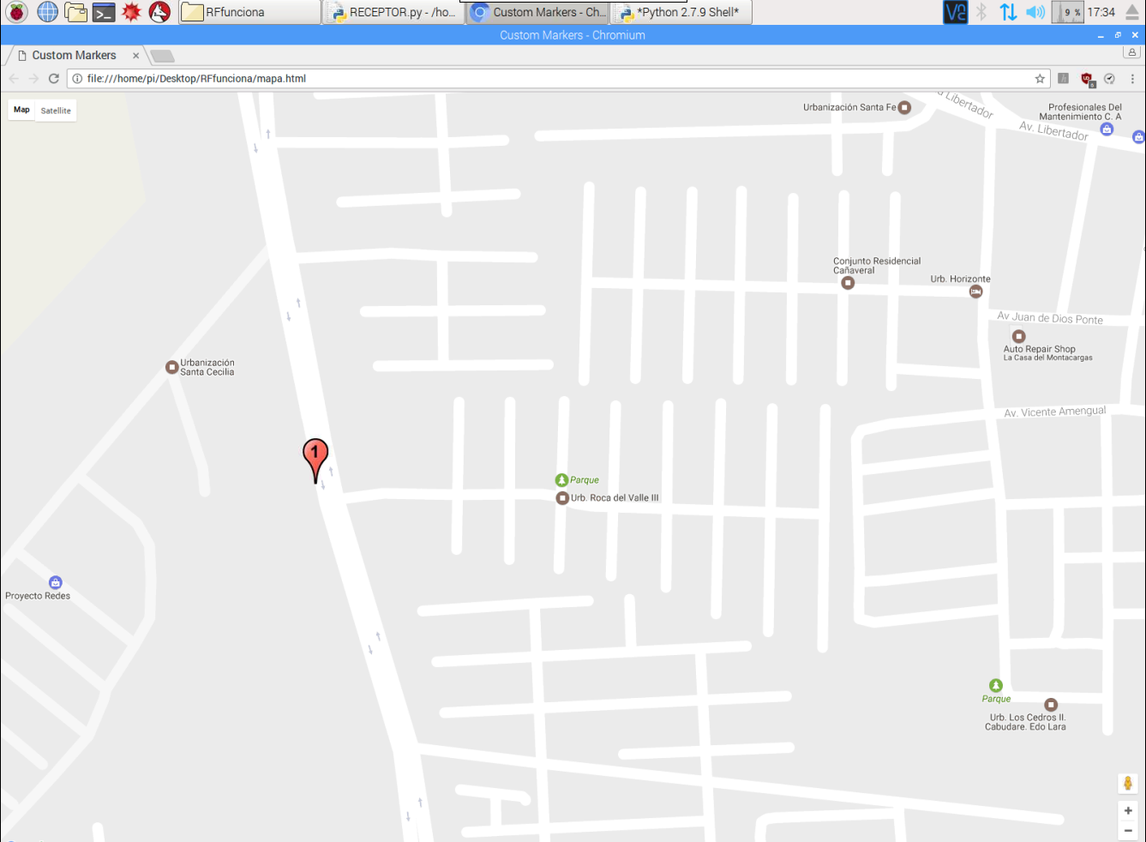
POSfinal.png
