grilletjesus/TESIS/Programa PIC.png

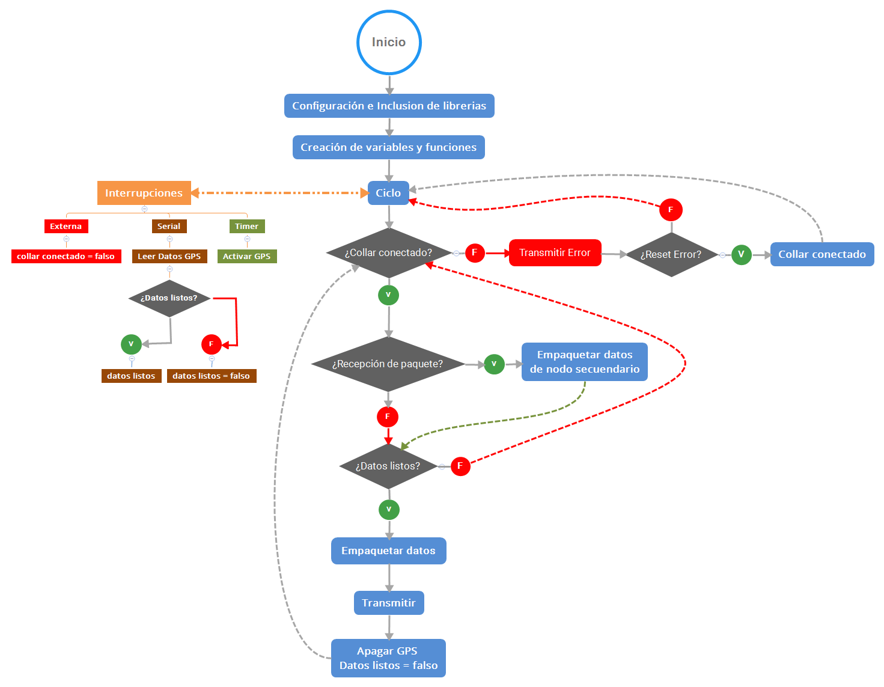
Programa PIC.png
