grilletjesus/TESIS/REgistrosRasp.png

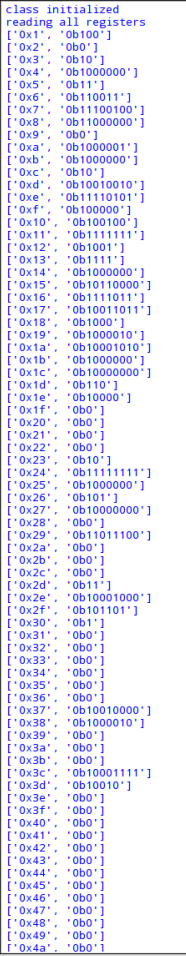
REgistrosRasp.png
