grilletjesus/TESIS/prueba1.png

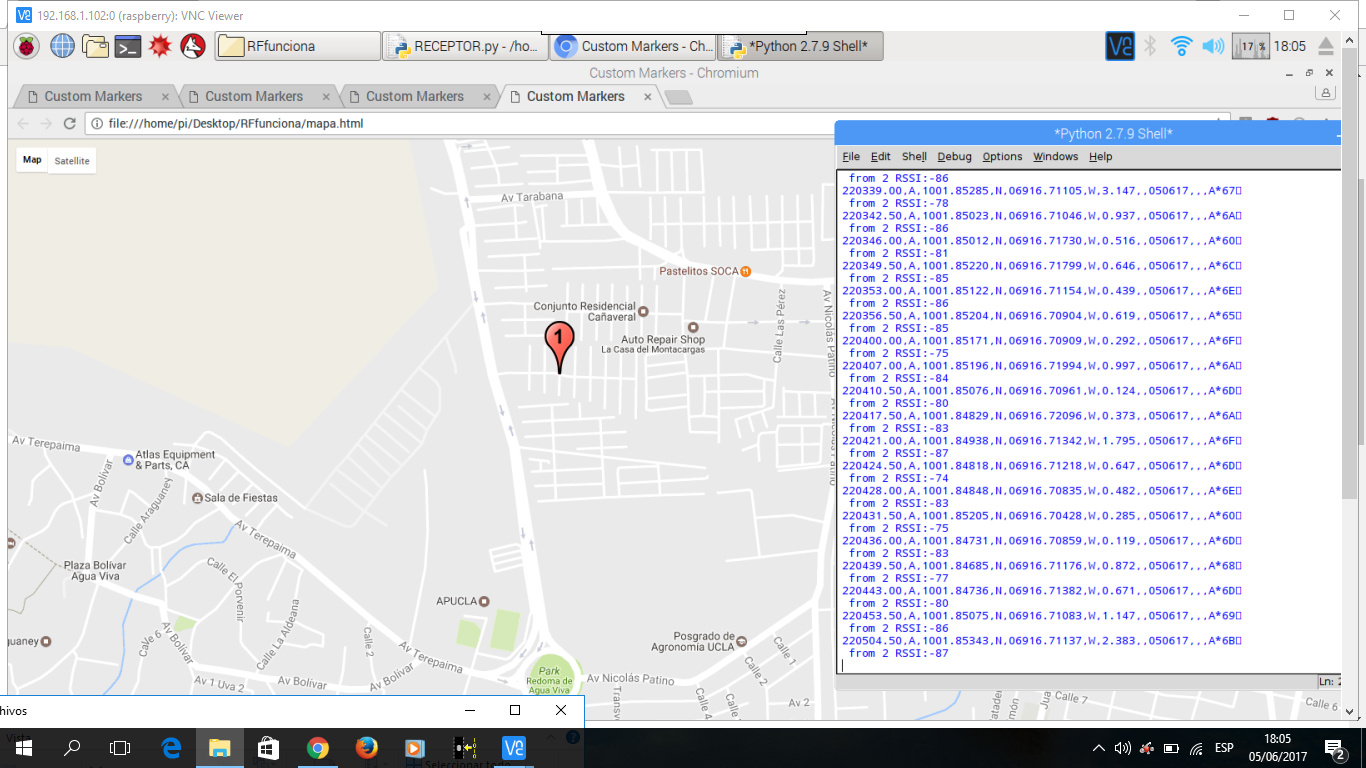
prueba1.png
