grilletjesus/TESIS/prueba2.png

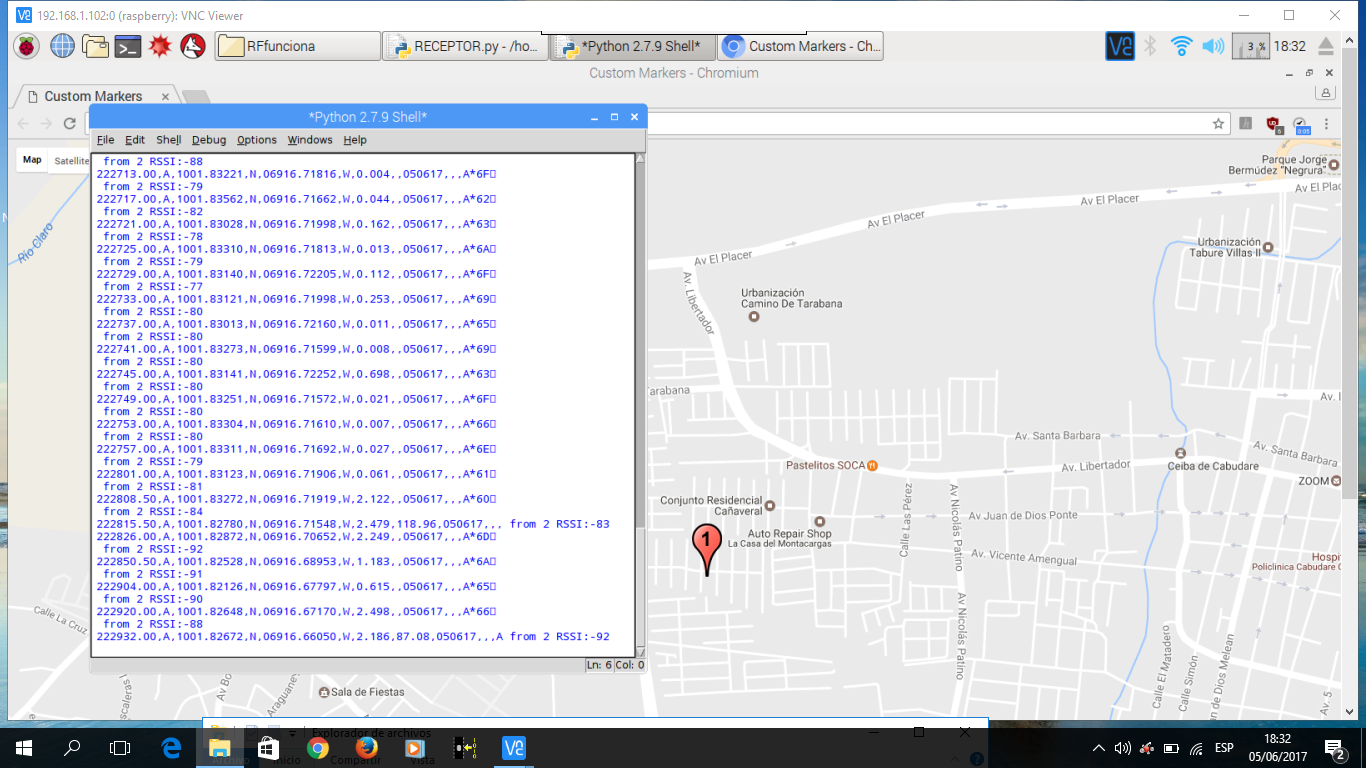
prueba2.png
