grilletjesus/TESIS/(list of files, drawings)

Other design files:
collarCircuit.DSN
